hexeguitar/EncoderBoard/PSoc4_ExampleProject/Readme.md

## Rotary encoder board / I2C driven LED ring  ##
#### Example project for Cypress PSoc4 Pioneer Kit ####

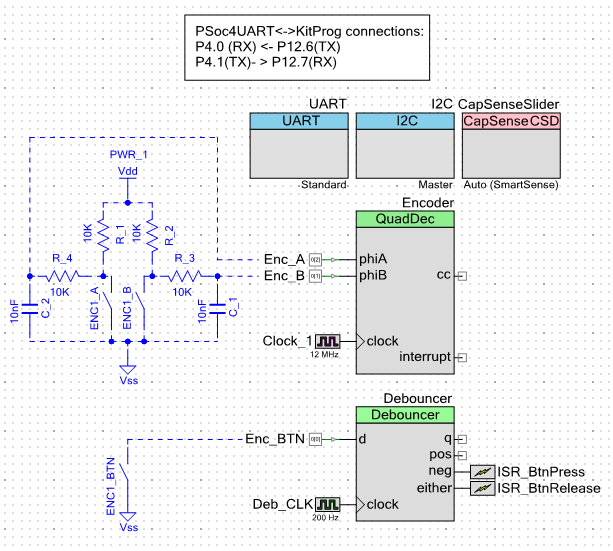
[picture p3: PSoc4_ExampleProject/PSoCprj.png]
EncoderBoard


<a href="http://www.youtube.com/watch?feature=player_embedded&v=pAu45C86ig8
" target="_blank">IMAGE ALT TEXT HERE</a>

------
(c) 04.2016 by Piotr Zapart 
www.hexeguitar.com

License:
Creative Commons - Attribution - ShareAlike 3.0 
[http://creativecommons.org/licenses/by-sa/3.0/](http://creativecommons.org/licenses/by-sa/3.0/)
