hexeguitar/EncoderBoard/pics/EncLED1.jpg

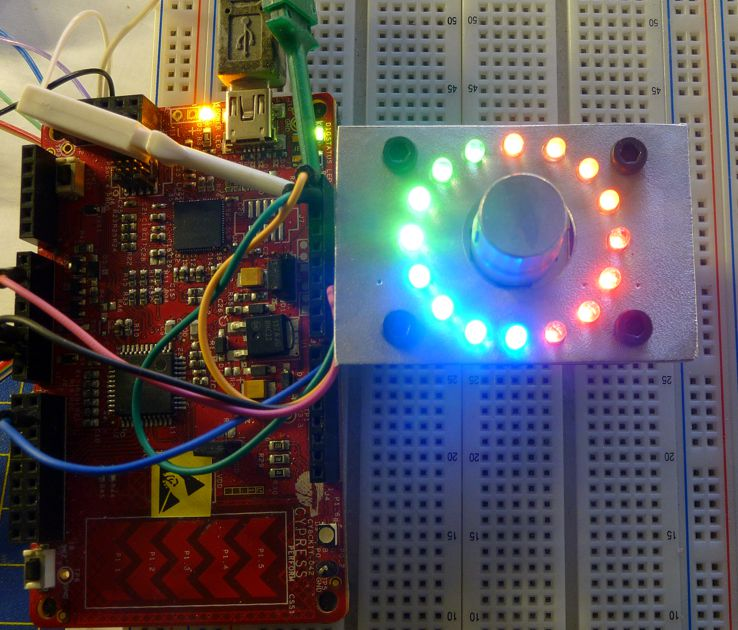
pics/EncLED1.jpg
