hexeguitar/EncoderBoard/pics/EncLED2.jpg

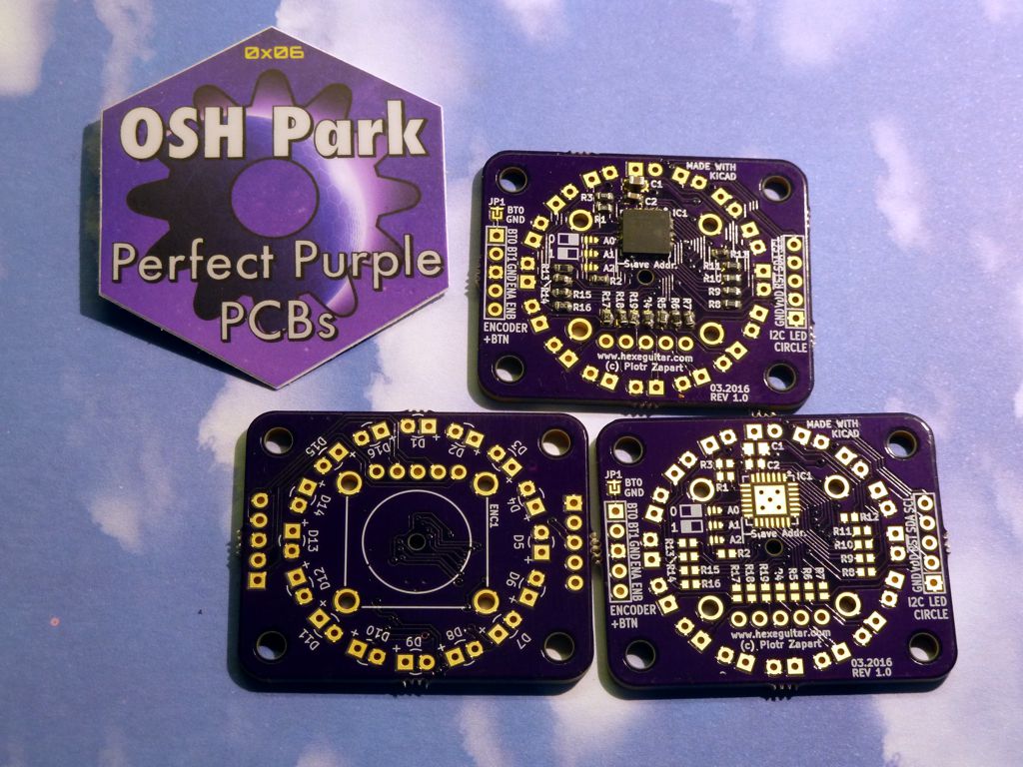
pics/EncLED2.jpg
