hexeguitar/EncoderBoard/pics/EncLED4.jpg

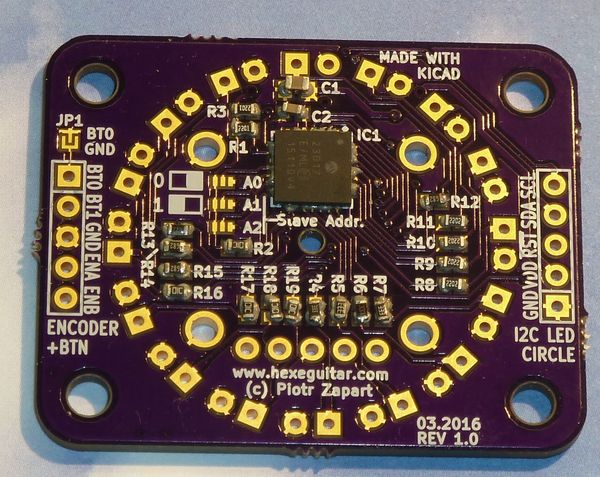
pics/EncLED4.jpg
