hexeguitar/EncoderBoard/pics/EncLED5.jpg

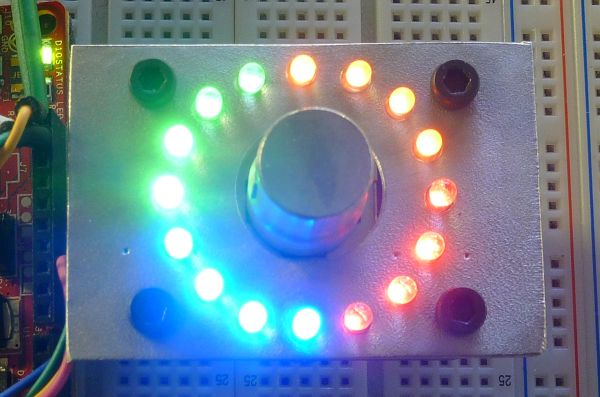
pics/EncLED5.jpg
