hexeguitar/EncoderBoard/EncLED_schm.pdf

# BOM

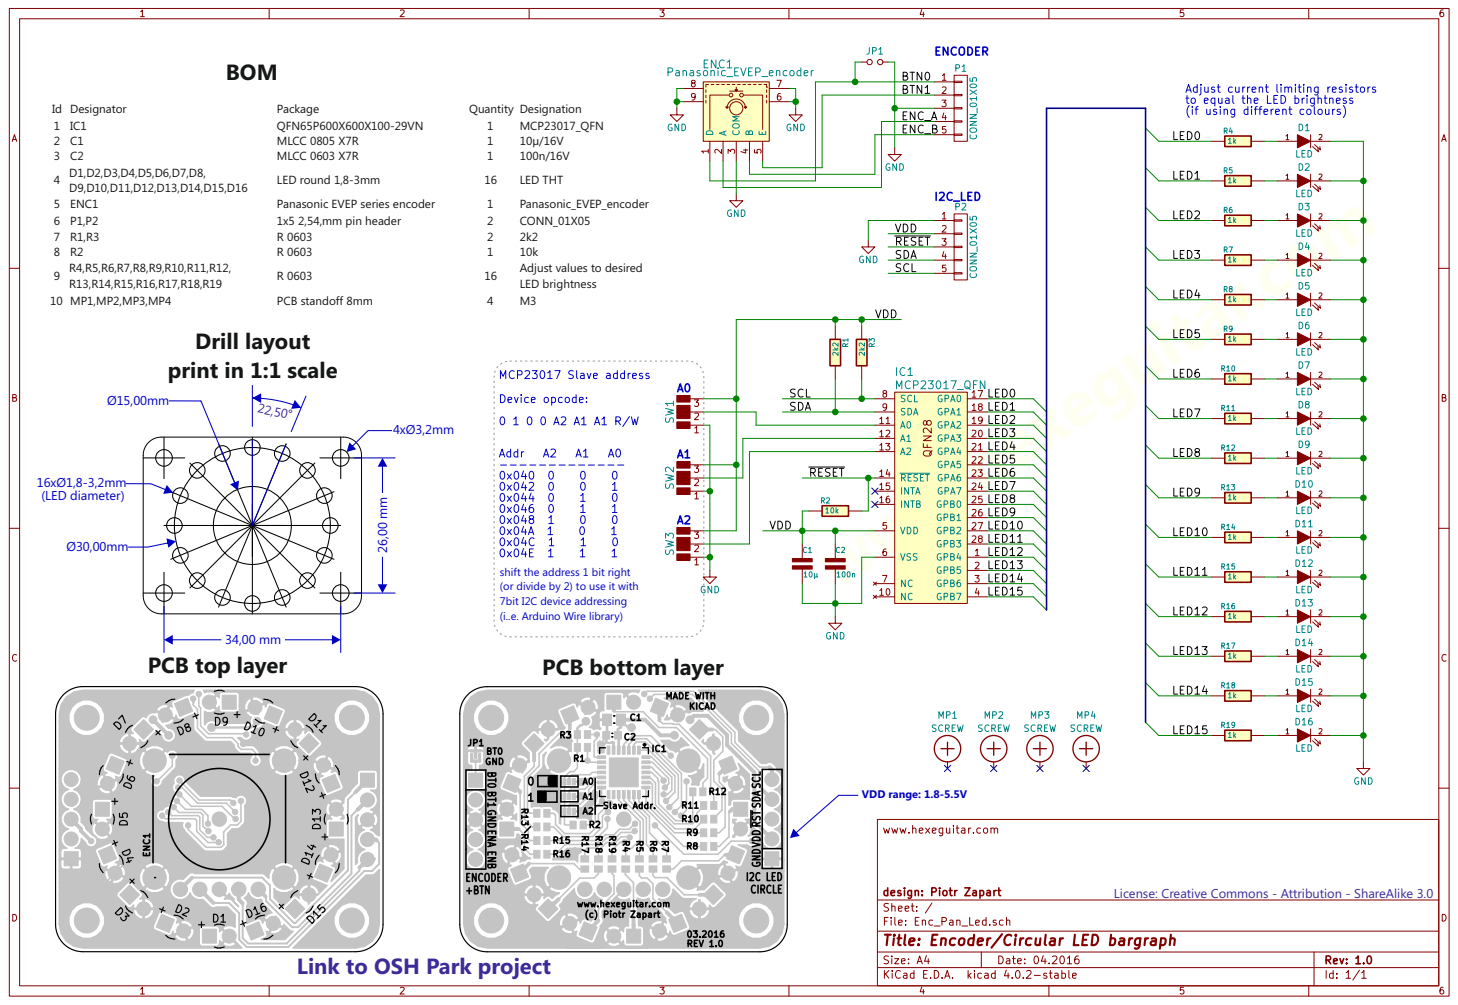
[picture p8: page 1]
PCB top layer; PCB bottom layer; 16xØ1,8-3,2mm (LED diameter); Designation; QFN65P600X600X100-29VN; MCP23017_QFN; MLCC 0805 X7R; MLCC 0603 X7R; LED THT; 5 ENC1; CONN_01X05; Id Designator; Package; Quantity; LED round 1,8-3mm; Panasonic EVEP series encoder; Panasonic_EVEP_encoder; PCB standoff 8mm; VDD range: 1.8-5.5V

1x5 2,54,mm pin header

Adjust values to desired
LED brightness

Drill layout
print in 1:1 scale

shift the address 1 bit right
(or divide by 2) to use it with
7bit I2C device addressing
(i..e. Arduino Wire library)

License: Creative Commons - Attribution - ShareAlike 3.0 (http://creativecommons.org/licenses/by-sa/3.0/)

Link to OSH Park project (https://www.oshpark.com/shared_projects/Tbhe3eJt)
