hexeguitar/EncoderBoard/kicad_project/Enc_Pan_Led.kicad_pcb

## KiCad design kicad_project/Enc_Pan_Led.kicad_pcb (2016-04-06)

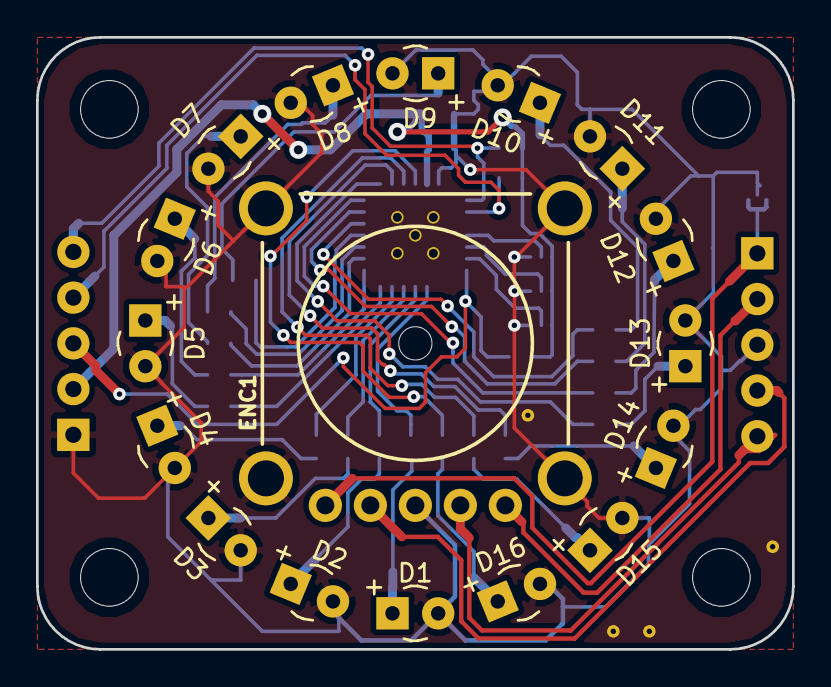
[picture p9: board Enc_Pan_Led.kicad_pcb from above]

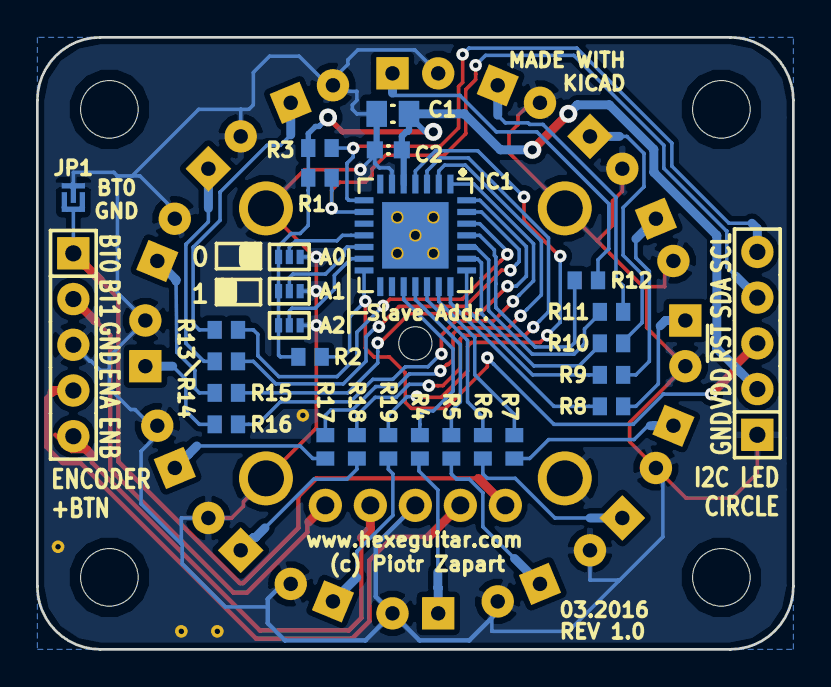
[picture p10: board Enc_Pan_Led.kicad_pcb from below]

Board: 2 copper layers, 42.0 x 34.0 mm, 58 parts (28 on the bottom side), 44 nets.

Parts:
C1: 10µ; CAPC_0805_2012X70N
C2: 100n; CAPC_0603_1608X55N
D1, D2, D3, D4, D5, D6, D7, D8, D9, D10, D11, D12, D13, D14, D15, D16: LED; Diode_LED_3mm_round_vertical
ENC1: Panasonic_EVEP_encoder; PanasonicEVEP_Encoder
IC1: MCP23017_QFN; QFN65P600X600X100-29VN
JP1: Jumper_NO_Small; PCB_jumper_2
MP1, MP2, MP3, MP4: SCREW; MountingHole_3-5mm
P1, P2: CONN_01X05; 1x5_254
R1, R3: 2k2; RESC_0603_1508X63N
R2: 10k; RESC_0603_1508X63N
R4, R5, R6, R7, R8, R9, R10, R11, R12, R13, R14, R15, R16, R17, R18, R19: R; RESC_0603_1508X63N
SW1, SW2, SW3: PCB_SPDT; SPDT_BlobSwitch_SMD
Via0703_GND, Via0703_GND#2, Via0703_GND#3, Via0703_GND#4, Via0703_GND#5, Via0703_GND#6, Via0703_GND#7, Via0703_GND#8, Via0703_GND#9: VAL**; Via0703_GND

Connections:
/BTN0: ENC1.1, JP1.1, P1.1
/BTN1: ENC1.5, P1.2
/ENC_A: ENC1.2, P1.4
/ENC_B: ENC1.4, P1.5
/LED0: IC1.17, R4.2
/LED1: IC1.18, R5.2
/LED2: IC1.19, R6.2
/LED3: IC1.20, R7.2
/LED4: IC1.21, R8.2
/LED5: IC1.22, R9.2
/LED6: IC1.23, R10.2
/LED7: IC1.24, R11.2
/LED8: IC1.25, R12.2
/LED9: IC1.26, R13.2
/LED10: IC1.27, R14.2
/LED11: IC1.28, R15.2
/LED12: IC1.1, R16.2
/LED13: IC1.2, R17.2
/LED14: IC1.3, R18.2
/LED15: IC1.4, R19.2
/SCL: IC1.8, P2.5, R3.1
/SDA: IC1.9, P2.4, R1.1
/VDD: C1.1, C2.1, IC1.5, P2.2, R1.2, R2.2, R3.2, SW1.3, SW2.3, SW3.3
/~RESET: IC1.14, P2.3, R2.1
GND: C1.2, C2.2, D1.2, D2.2, D3.2, D4.2, D5.2, D6.2, D7.2, D8.2, D9.2, D10.2, D11.2, D12.2, D13.2, D14.2, D15.2, D16.2, ENC1.3, ENC1.6, ENC1.7, ENC1.8, ENC1.9, IC1.6, IC1.29, JP1.2, P1.3, P2.1, SW1.1, SW2.1, SW3.1, Via0703_GND.1, Via0703_GND#2.1, Via0703_GND#3.1, Via0703_GND#4.1, Via0703_GND#5.1, Via0703_GND#6.1, Via0703_GND#7.1, Via0703_GND#8.1, Via0703_GND#9.1
unnamed: D1.1, R4.1
unnamed: D2.1, R5.1
unnamed: D3.1, R6.1
unnamed: D4.1, R7.1
unnamed: D5.1, R8.1
unnamed: D6.1, R9.1
unnamed: D7.1, R10.1
unnamed: D8.1, R11.1
unnamed: D9.1, R12.1
unnamed: D10.1, R13.1
unnamed: D11.1, R14.1
unnamed: D12.1, R15.1
unnamed: D13.1, R16.1
unnamed: D14.1, R17.1
unnamed: D15.1, R18.1
unnamed: D16.1, R19.1
unnamed: IC1.11, SW1.2
unnamed: IC1.12, SW2.2
unnamed: IC1.13, SW3.2
